marekw1986/8085Computer/code/shadowed_rom/CPMBootloader/README.md

# POLON 7880

This is code of TinyBsic for final version of POLON 7880, build on PCBs.
