marekw1986/8085Computer/hardware/shadower.brd

## EAGLE design hardware/shadower.brd (2025-04-10)

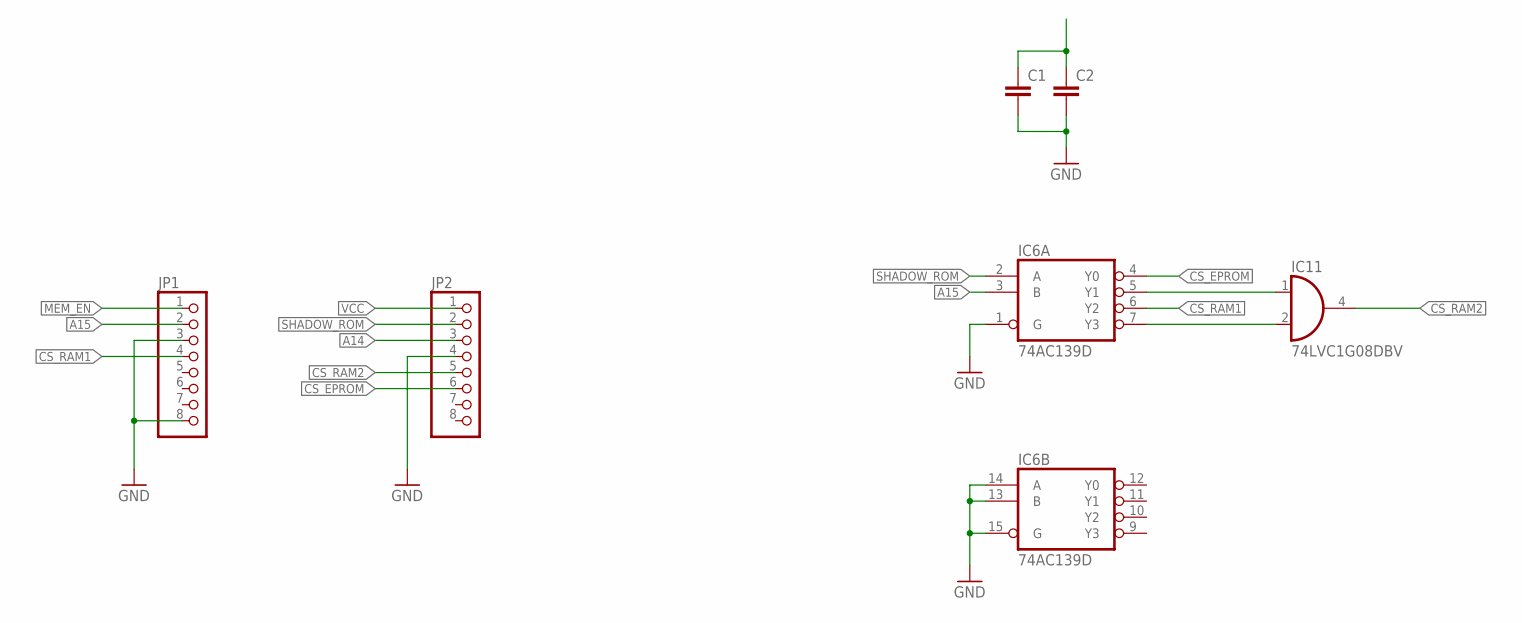
[picture p1: schematic shadower.sch]

Parts:
C1, C2: C-EUC0603; C0603
IC6: 74AC139D; SO16
IC11: 74LVC1G08DBV; SOT23-5
JP1, JP2: PINHD-1X8; 1X08

Connections:
A14: JP2.3
A15: IC6.3 (B), JP1.2
CS_EPROM: IC6.4 (Y0), JP2.6
CS_RAM1: IC6.6 (Y2), JP1.4
CS_RAM2: IC11.4 (O), JP2.5
GND: C1.2, C2.2, IC6.1 (G), IC6.8 (GND), IC6.13 (B), IC6.14 (A), IC6.15 (G), IC11.3 (GND), JP1.3, JP1.8, JP2.4
MEM_EN: JP1.1
unnamed: IC6.5 (Y1), IC11.1 (I0)
unnamed: IC6.7 (Y3), IC11.2 (I1)
SHADOW_ROM: IC6.2 (A), JP2.2
VCC: C1.1, C2.1, IC6.16 (VCC), IC11.5 (VCC), JP2.1

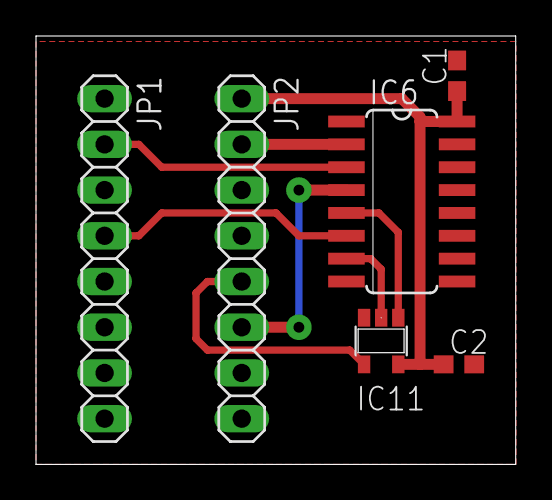
[picture p2: board shadower.brd from above]

Board: 2 copper layers, 26.6 x 23.8 mm, 6 parts (0 on the bottom side), 9 nets.
