marekw1986/8085Computer/hardware/8085_shadow.brd

## EAGLE design hardware/8085_shadow.brd (2025-02-12)

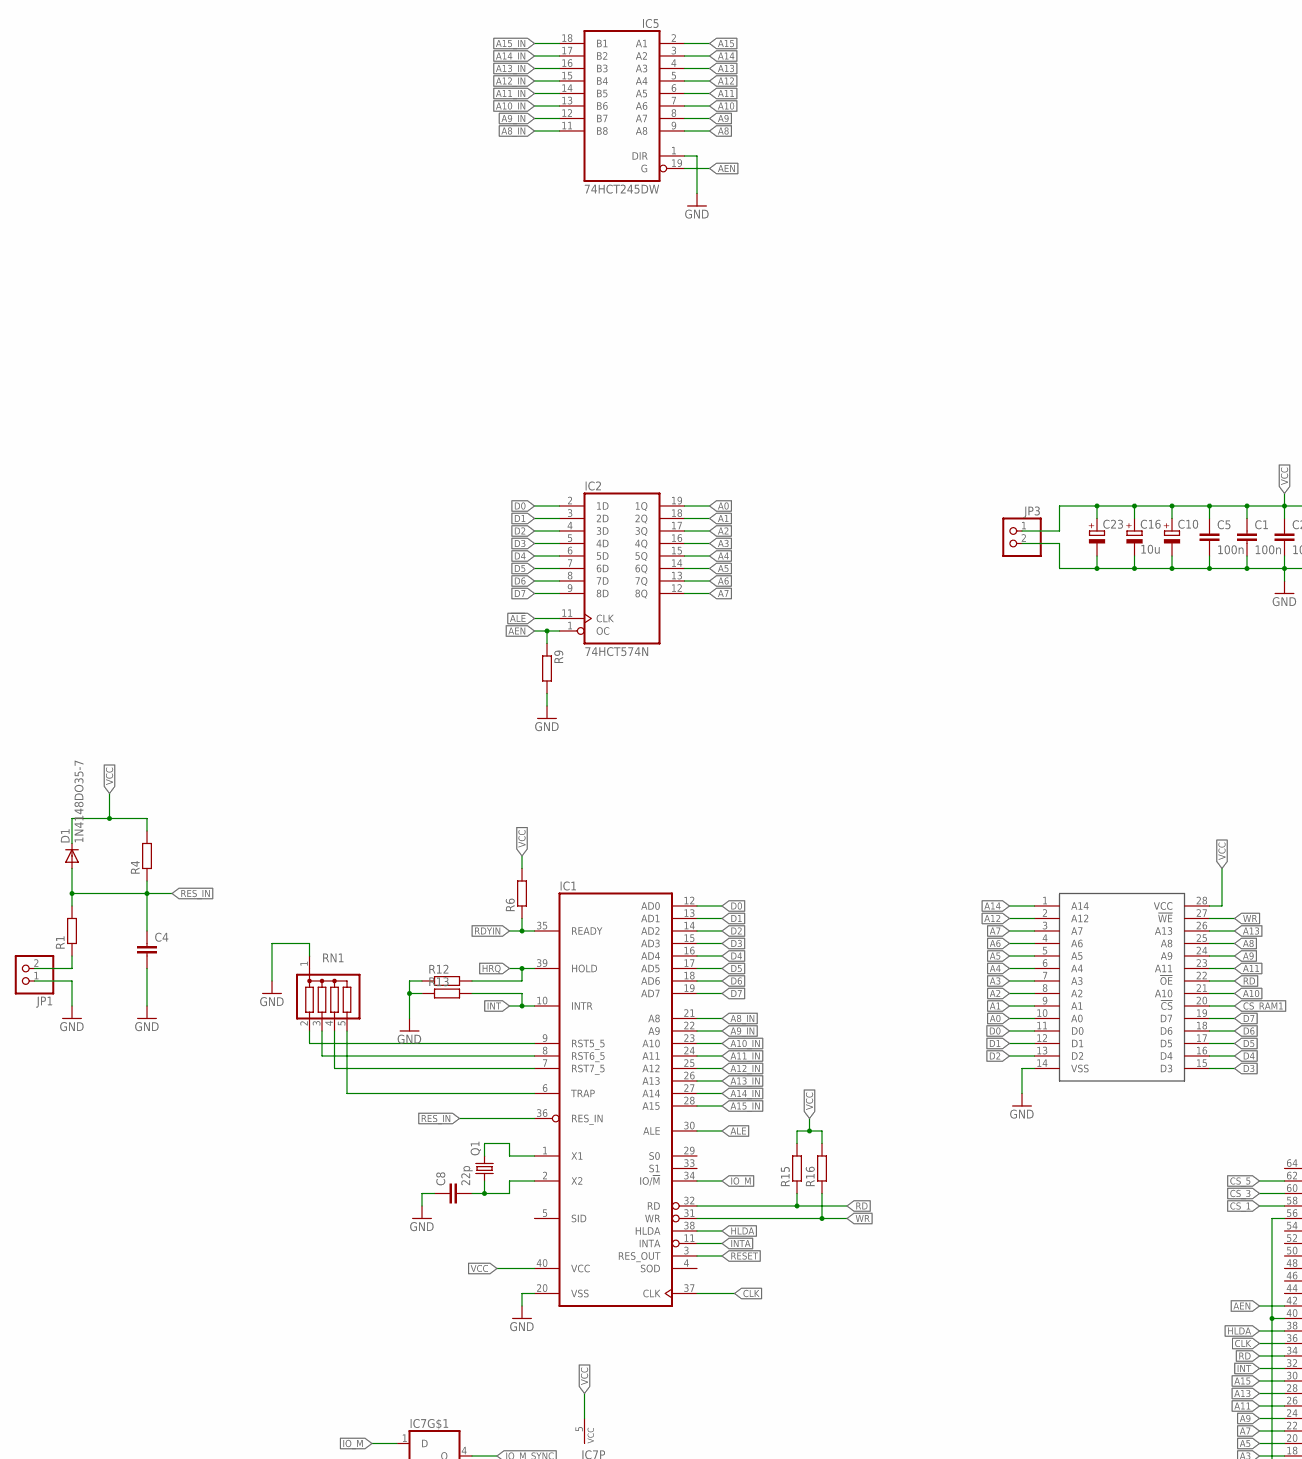
[picture p3: schematic 8085_shadow.sch, part in row 1, column 1]

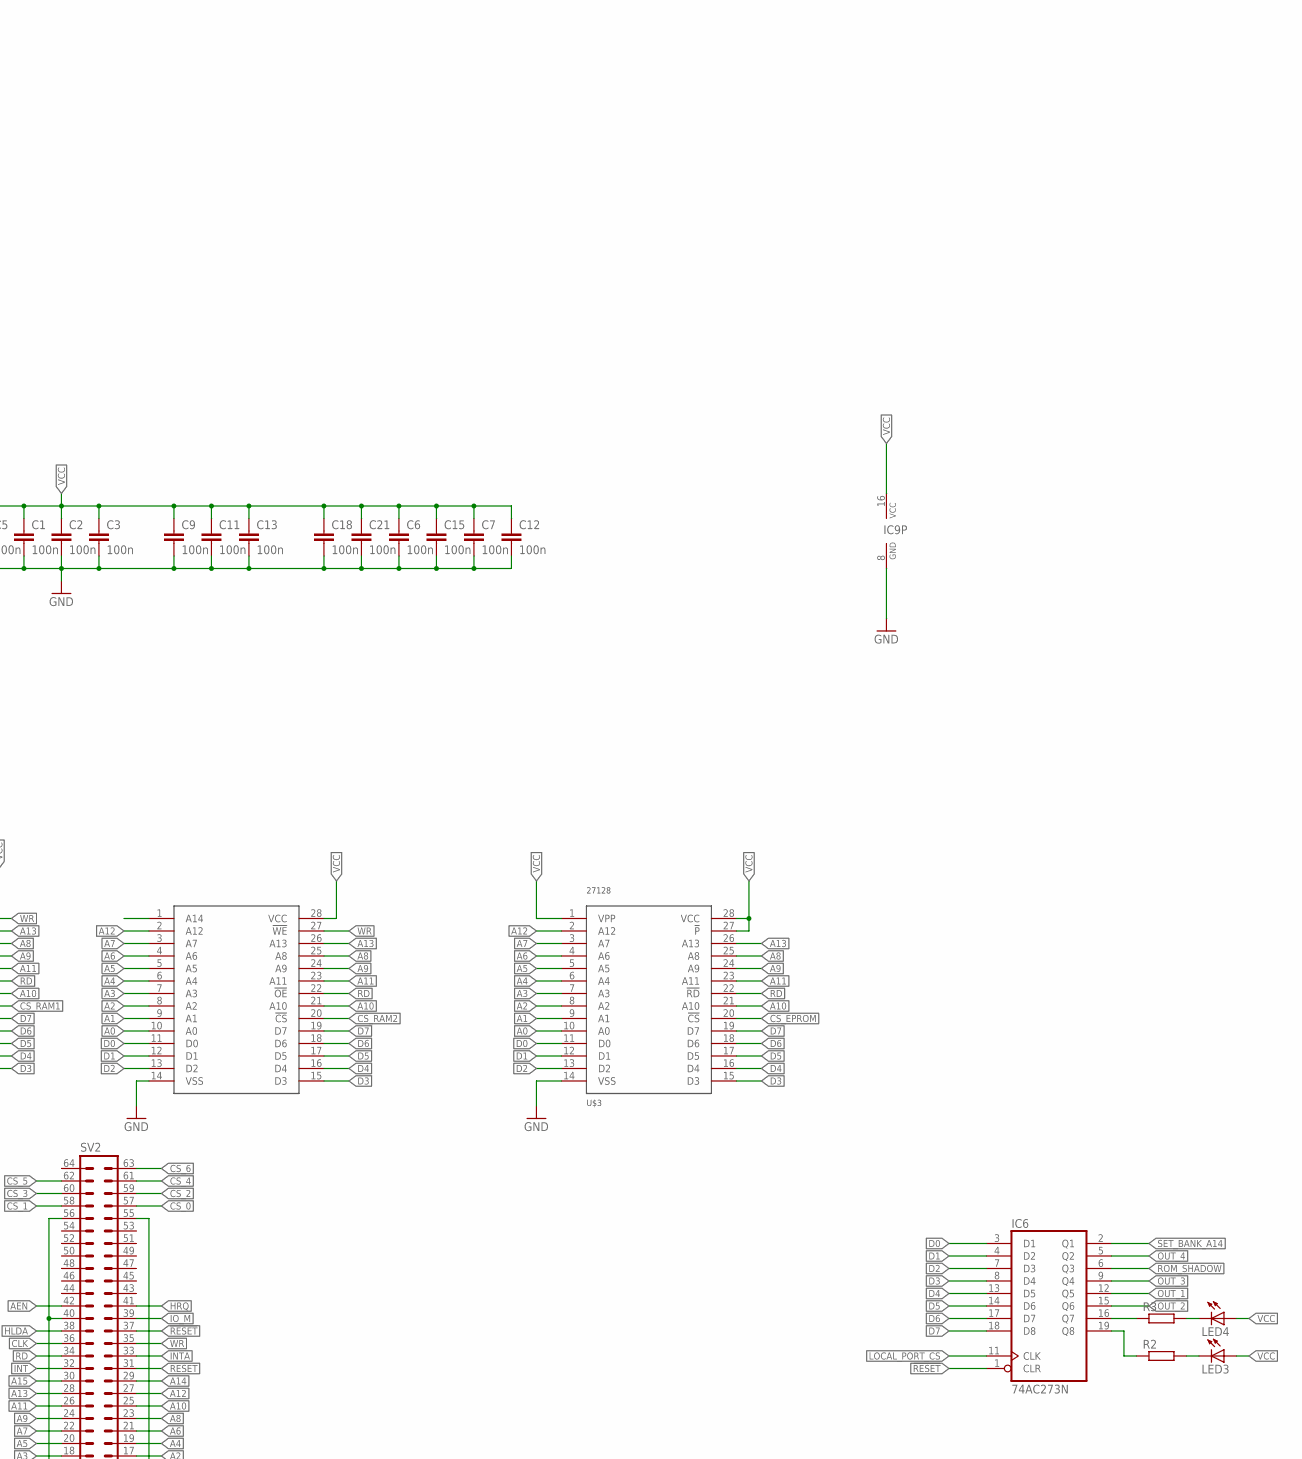
[picture p4: schematic 8085_shadow.sch, part in row 1, column 2]

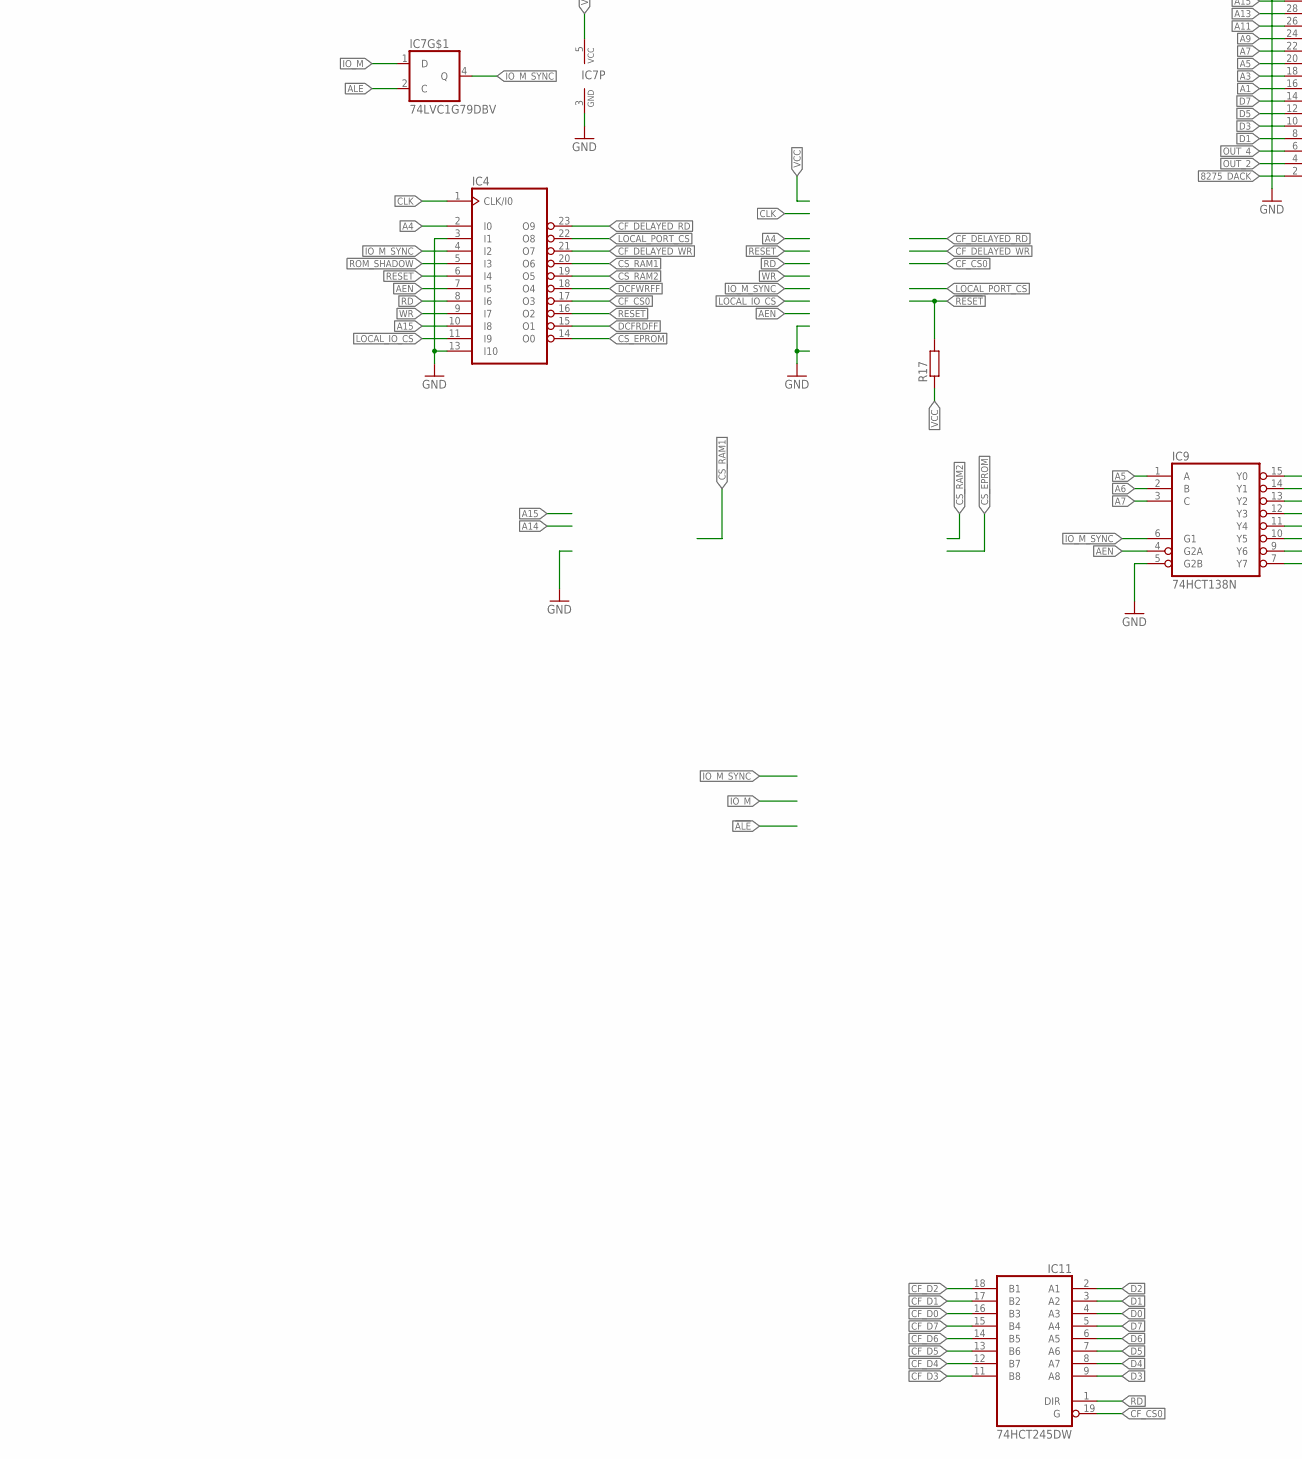
[picture p5: schematic 8085_shadow.sch, part in row 2, column 1]

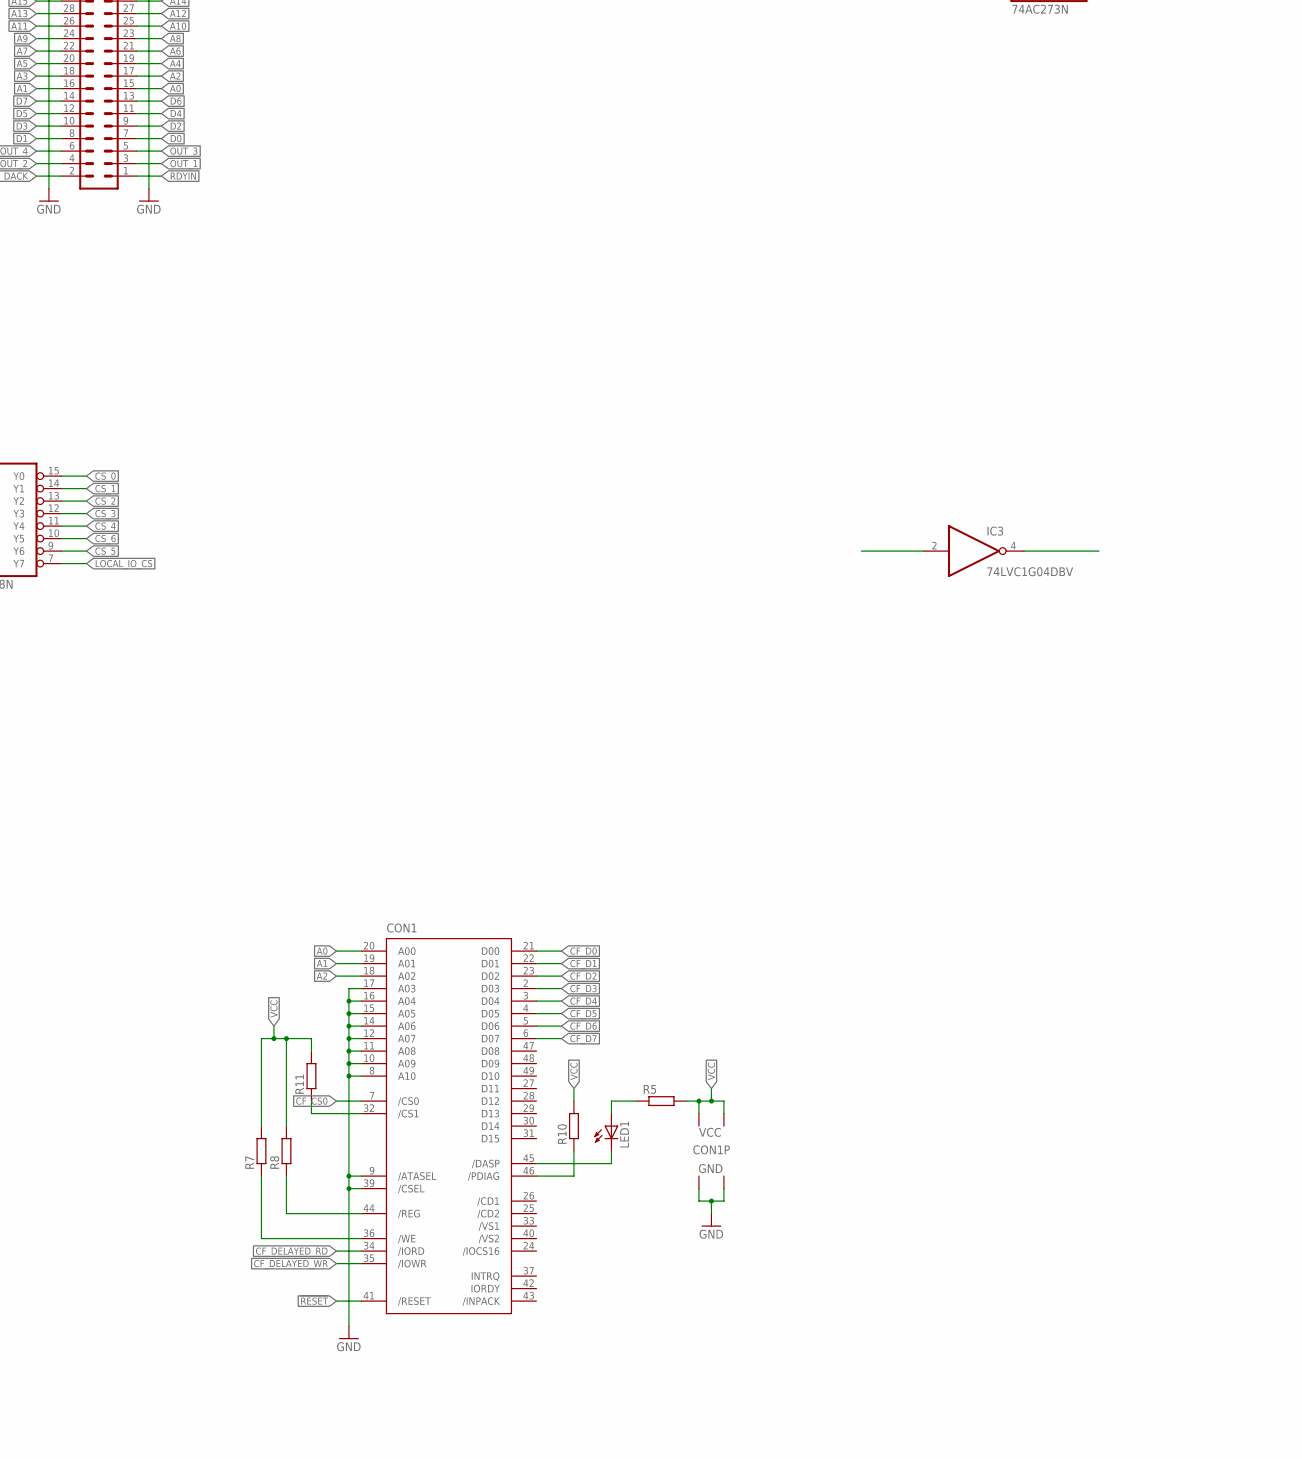
[picture p6: schematic 8085_shadow.sch, part in row 2, column 2]

Parts:
C1, C2, C3, C11, C12, C13: 100n; C0805
C4: C-EUC0603; C0603
C5, C6, C7, C15, C18, C21: 100n; C0603
C8: 22p; C0603
C9: 100n; C1206
C10, C23: CPOL-EUE5-10.5; E5-10,5
C16: 10u; SMC_B
CON1: CF-CARD-IDE_MODE; MI20-50PD-SF
D1: 1N4148DO35-7; DO35-7
IC1: 8085; DIL40
IC2: 74HCT574N; DIL20
IC3: 74LVC1G04DBV; SOT23-5
IC4: 22V10; DIL24-3
IC5, IC11: 74HCT245DW; SO20W
IC6: 74AC273N; DIL20
IC7: 74LVC1G79DBV; SOT23-5
IC9: 74HCT138N; DIL16
JP1, JP3: PINHD-1X2; 1X02
LED1, LED3, LED4: LED5MM
Q1: CRYSTALHC49S; HC49/S
R1, R6: R-EU_0204/5; 0204/5
R2, R3: R-EU_R1206; R1206
R4, R15, R16, R17: R-EU_0204/7; 0204/7
R5, R9, R12, R13: R-EU_R0603; R0603
R7, R11: R-EU_0207/10; 0207/10
R8, R10: R-EU_0207/12; 0207/12
RN1: G04R; SIL5
SV2: ML64L
U$2, U$4: 62256; DIL28-6
U$3: 27128; DIL28

Connections:
8275_DACK: SV2.2
!ALE: IC2.11 (CLK), IC3.4 (O), IC7.2 (C)
!RESET: CON1.41 (/RESET), IC4.16 (O2), IC6.1 (CLR), R17.2, SV2.37
A0: CON1.20 (A00), IC2.19 (1Q), SV2.15, U$2.10 (A0), U$3.10 (A0), U$4.10 (A0)
A1: CON1.19 (A01), IC2.18 (2Q), SV2.16, U$2.9 (A1), U$3.9 (A1), U$4.9 (A1)
A2: CON1.18 (A02), IC2.17 (3Q), SV2.17, U$2.8 (A2), U$3.8 (A2), U$4.8 (A2)
A3: IC2.16 (4Q), SV2.18, U$2.7 (A3), U$3.7 (A3), U$4.7 (A3)
A4: IC2.15 (5Q), IC4.2 (I0), SV2.19, U$2.6 (A4), U$3.6 (A4), U$4.6 (A4)
A5: IC2.14 (6Q), IC9.1 (A), SV2.20, U$2.5 (A5), U$3.5 (A5), U$4.5 (A5)
A6: IC2.13 (7Q), IC9.2 (B), SV2.21, U$2.4 (A6), U$3.4 (A6), U$4.4 (A6)
A7: IC2.12 (8Q), IC9.3 (C), SV2.22, U$2.3 (A7), U$3.3 (A7), U$4.3 (A7)
A8: IC5.9 (A8), SV2.23, U$2.25 (A8), U$3.25 (A8), U$4.25 (A8)
A8_IN: IC1.21 (A8), IC5.11 (B8)
A9: IC5.8 (A7), SV2.24, U$2.24 (A9), U$3.24 (A9), U$4.24 (A9)
A9_IN: IC1.22 (A9), IC5.12 (B7)
A10: IC5.7 (A6), SV2.25, U$2.21 (A10), U$3.21 (A10), U$4.21 (A10)
A10_IN: IC1.23 (A10), IC5.13 (B6)
A11: IC5.6 (A5), SV2.26, U$2.23 (A11), U$3.23 (A11), U$4.23 (A11)
A11_IN: IC1.24 (A11), IC5.14 (B5)
A12: IC5.5 (A4), SV2.27, U$2.2 (A12), U$3.2 (A12), U$4.2 (A12)
A12_IN: IC1.25 (A12), IC5.15 (B4)
A13: IC5.4 (A3), SV2.28, U$2.26 (A13), U$3.26 (A13), U$4.26 (A13)
A13_IN: IC1.26 (A13), IC5.16 (B3)
A14: IC5.3 (A2), SV2.29, U$2.1 (A14), U$4.1 (A14)
A14_IN: IC1.27 (A14), IC5.17 (B2)
A15: IC4.10 (I8), IC5.2 (A1), SV2.30
A15_IN: IC1.28 (A15), IC5.18 (B1)
AEN: IC2.1 (OC), IC4.7 (I5), IC5.19 (G), IC9.4 (G2A), R9.1, SV2.42
ALE: IC1.30 (ALE), IC3.2 (I)
CF_CS0: CON1.7 (/CS0), IC4.17 (O3), IC11.19 (G)
CF_D0: CON1.21 (D00), IC11.16 (B3)
CF_D1: CON1.22 (D01), IC11.17 (B2)
CF_D2: CON1.23 (D02), IC11.18 (B1)
CF_D3: CON1.2 (D03), IC11.11 (B8)
CF_D4: CON1.3 (D04), IC11.12 (B7)
CF_D5: CON1.4 (D05), IC11.13 (B6)
CF_D6: CON1.5 (D06), IC11.14 (B5)
CF_D7: CON1.6 (D07), IC11.15 (B4)
CF_DELAYED_RD: CON1.34 (/IORD), IC4.23 (O9)
CF_DELAYED_WR: CON1.35 (/IOWR), IC4.21 (O7)
CLK: IC1.37 (CLK), IC4.1 (CLK/I0), SV2.36
CS_0: IC9.15 (Y0), SV2.57
CS_1: IC9.14 (Y1), SV2.58
CS_2: IC9.13 (Y2), SV2.59
CS_3: IC9.12 (Y3), SV2.60
CS_4: IC9.11 (Y4), SV2.61
CS_5: IC9.9 (Y6), SV2.62
CS_6: IC9.10 (Y5), SV2.63
CS_EPROM: IC4.14 (O0), U$3.20 (!CS)
CS_RAM1: IC4.20 (O6), U$4.20 (!CS)
CS_RAM2: IC4.19 (O5), U$2.20 (!CS)
D0: IC1.12 (AD0), IC2.2 (1D), IC6.3 (D1), IC11.4 (A3), SV2.7, U$2.11 (D0), U$3.11 (D0), U$4.11 (D0)
D1: IC1.13 (AD1), IC2.3 (2D), IC6.4 (D2), IC11.3 (A2), SV2.8, U$2.12 (D1), U$3.12 (D1), U$4.12 (D1)
D2: IC1.14 (AD2), IC2.4 (3D), IC6.7 (D3), IC11.2 (A1), SV2.9, U$2.13 (D2), U$3.13 (D2), U$4.13 (D2)
D3: IC1.15 (AD3), IC2.5 (4D), IC6.8 (D4), IC11.9 (A8), SV2.10, U$2.15 (D3), U$3.15 (D3), U$4.15 (D3)
D4: IC1.16 (AD4), IC2.6 (5D), IC6.13 (D5), IC11.8 (A7), SV2.11, U$2.16 (D4), U$3.16 (D4), U$4.16 (D4)
D5: IC1.17 (AD5), IC2.7 (6D), IC6.14 (D6), IC11.7 (A6), SV2.12, U$2.17 (D5), U$3.17 (D5), U$4.17 (D5)
D6: IC1.18 (AD6), IC2.8 (7D), IC6.17 (D7), IC11.6 (A5), SV2.13, U$2.18 (D6), U$3.18 (D6), U$4.18 (D6)
D7: IC1.19 (AD7), IC2.9 (8D), IC6.18 (D8), IC11.5 (A4), SV2.14, U$2.19 (D7), U$3.19 (D7), U$4.19 (D7)
DCFRDFF: IC4.15 (O1)
DCFWRFF: IC4.18 (O4)
GND: C1.2, C2.2, C3.2, C4.2, C5.2, C6.2, C7.2, C8.1, C9.2, C10.-, C11.2, C12.2, C13.2, C15.2, C16.-, C18.2, C21.2, C23.-, CON1.1 (GND1), CON1.8 (A10), CON1.9 (/ATASEL), CON1.10 (A09), CON1.11 (A08), CON1.12 (A07), CON1.14 (A06), CON1.15 (A05), CON1.16 (A04), CON1.17 (A03), CON1.39 (/CSEL), CON1.50 (GND2), IC1.20 (VSS), IC2.10 (GND), IC3.3 (GND), IC4.3 (I1), IC4.12 (GND), IC4.13 (I10), IC5.1 (DIR), IC5.10 (GND), IC6.10 (GND), IC7.3 (GND), IC9.5 (G2B), IC9.8 (GND), IC11.10 (GND), JP1.1, JP3.2, R9.2, R12.1, R13.1, RN1.1, SV2.40, SV2.55, SV2.56, U$2.14 (VSS), U$3.14 (VSS), U$4.14 (VSS)
HLDA: IC1.38 (HLDA), SV2.38
HRQ: IC1.39 (HOLD), R12.2, SV2.41
INT: IC1.10 (INTR), R13.2, SV2.32
INTA: IC1.11 (INTA), SV2.33
IO_M: IC1.34 (IO/!M), IC7.1 (D), SV2.39
IO_M_SYNC: IC4.4 (I2), IC7.4 (Q), IC9.6 (G1)
LOCAL_IO_CS: IC4.11 (I9), IC9.7 (Y7)
LOCAL_PORT_CS: IC4.22 (O8), IC6.11 (CLK)
unnamed: IC1.1 (X1), Q1.2
unnamed: C8.2, IC1.2 (X2), Q1.1
unnamed: IC1.9 (RST5_5), RN1.2
unnamed: IC1.8 (RST6_5), RN1.3
unnamed: IC6.16 (Q7), R3.1
unnamed: IC1.7 (RST7_5), RN1.4
unnamed: IC1.6 (TRAP), RN1.5
unnamed: LED3.K (C), R2.2
unnamed: LED4.K (C), R3.2
unnamed: IC6.19 (Q8), R2.1
unnamed: CON1.44 (/REG), R8.1
unnamed: CON1.36 (/WE), R7.1
unnamed: CON1.46 (/PDIAG), R10.1
unnamed: JP1.2, R1.1
unnamed: LED1.A, R5.1
unnamed: CON1.45 (/DASP), LED1.K (C)
unnamed: CON1.32 (/CS1), R11.1
OUT_1: IC6.12 (Q5), SV2.3
OUT_2: IC6.15 (Q6), SV2.4
OUT_3: IC6.9 (Q4), SV2.5
OUT_4: IC6.5 (Q2), SV2.6
RD: IC1.32 (RD), IC4.8 (I6), IC11.1 (DIR), R15.1, SV2.34, U$2.22 (!OE), U$3.22 (!RD), U$4.22 (!OE)
RDYIN: IC1.35 (READY), R6.1, SV2.1
RESET: IC1.3 (RES_OUT), IC4.6 (I4), SV2.31
RES_IN: C4.1, D1.A, IC1.36 (RES_IN), R1.2, R4.1
ROM_SHADOW: IC4.5 (I3), IC6.6 (Q3)
SET_BANK_A14: IC6.2 (Q1)
VCC: C1.1, C2.1, C3.1, C5.1, C6.1, C7.1, C9.1, C10.+, C11.1, C12.1, C13.1, C15.1, C16.+, C18.1, C21.1, C23.+, CON1.13 (VCC2), CON1.38 (VCC1), D1.C, IC1.40 (VCC), IC2.20 (VCC), IC3.5 (VCC), IC4.24 (VCC), IC5.20 (VCC), IC6.20 (VCC), IC7.5 (VCC), IC9.16 (VCC), IC11.20 (VCC), JP3.1, LED3.A, LED4.A, R4.2, R5.2, R6.2, R7.2, R8.2, R10.2, R11.2, R15.2, R16.2, R17.1, U$2.28 (VCC), U$3.1 (VPP), U$3.27 (!P), U$3.28 (VCC), U$4.28 (VCC)
WR: IC1.31 (WR), IC4.9 (I7), R16.1, SV2.35, U$2.27 (!WE), U$4.27 (!WE)

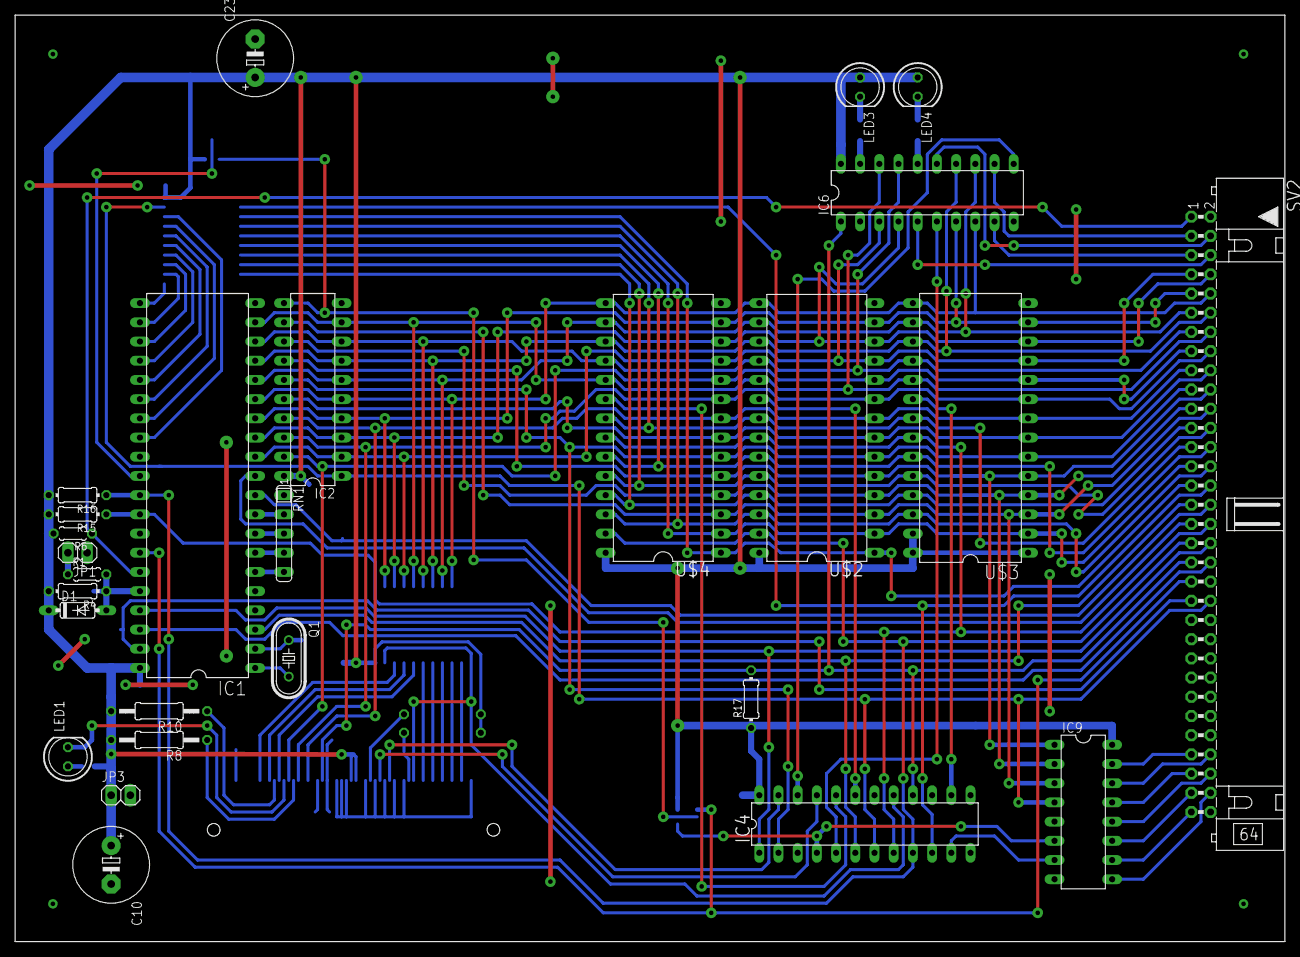
[picture p7: board 8085_shadow.brd from above]

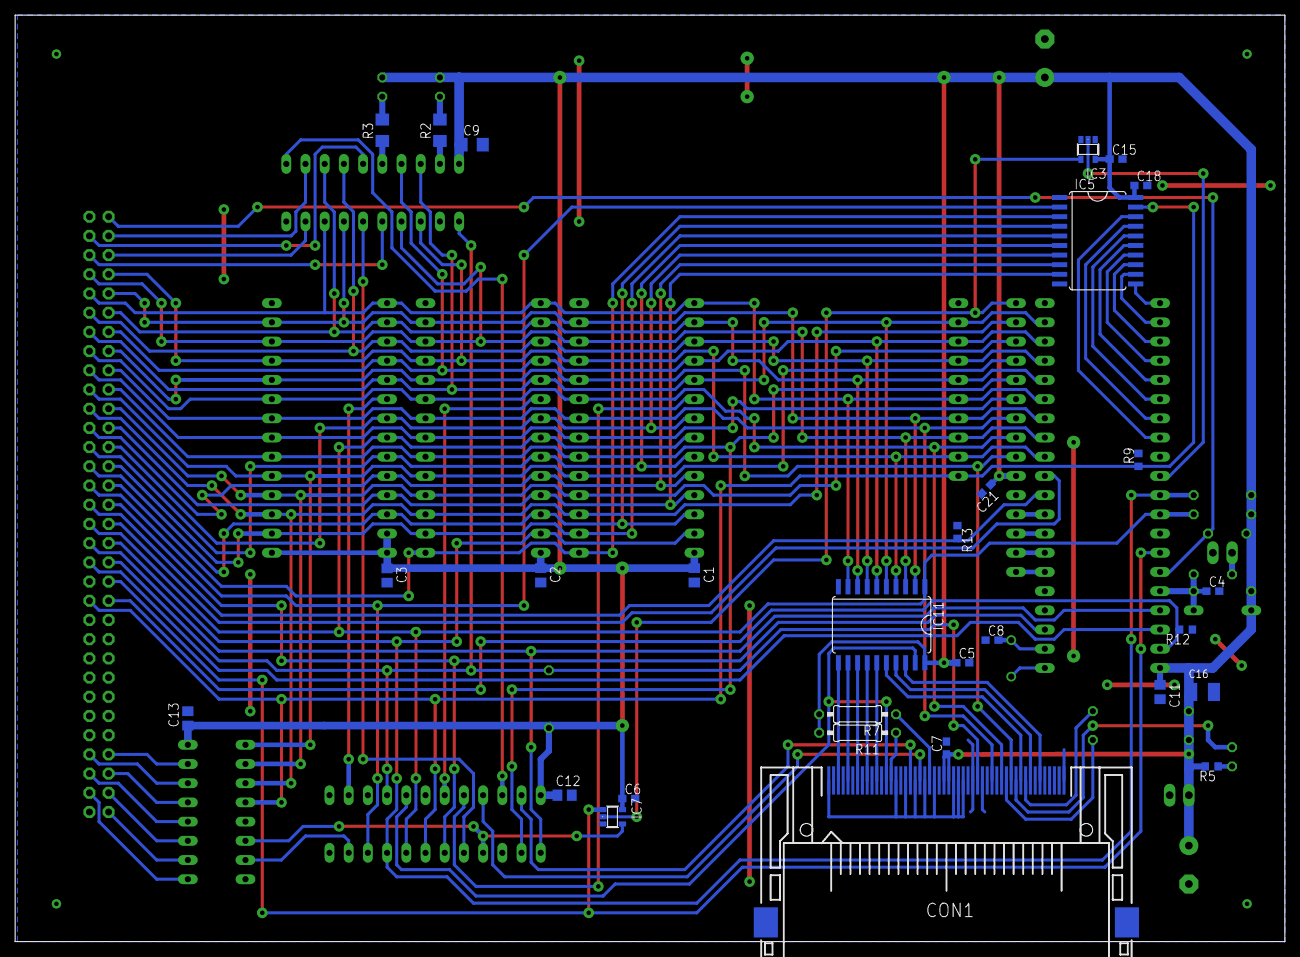
[picture p8: board 8085_shadow.brd from below]

Board: 2 copper layers, 167.9 x 122.5 mm, 56 parts (29 on the bottom side), 95 nets.
