marekw1986/8085Computer/hardware/8085_IO_LCD.brd

## EAGLE design hardware/8085_IO_LCD.brd (2024-09-18)

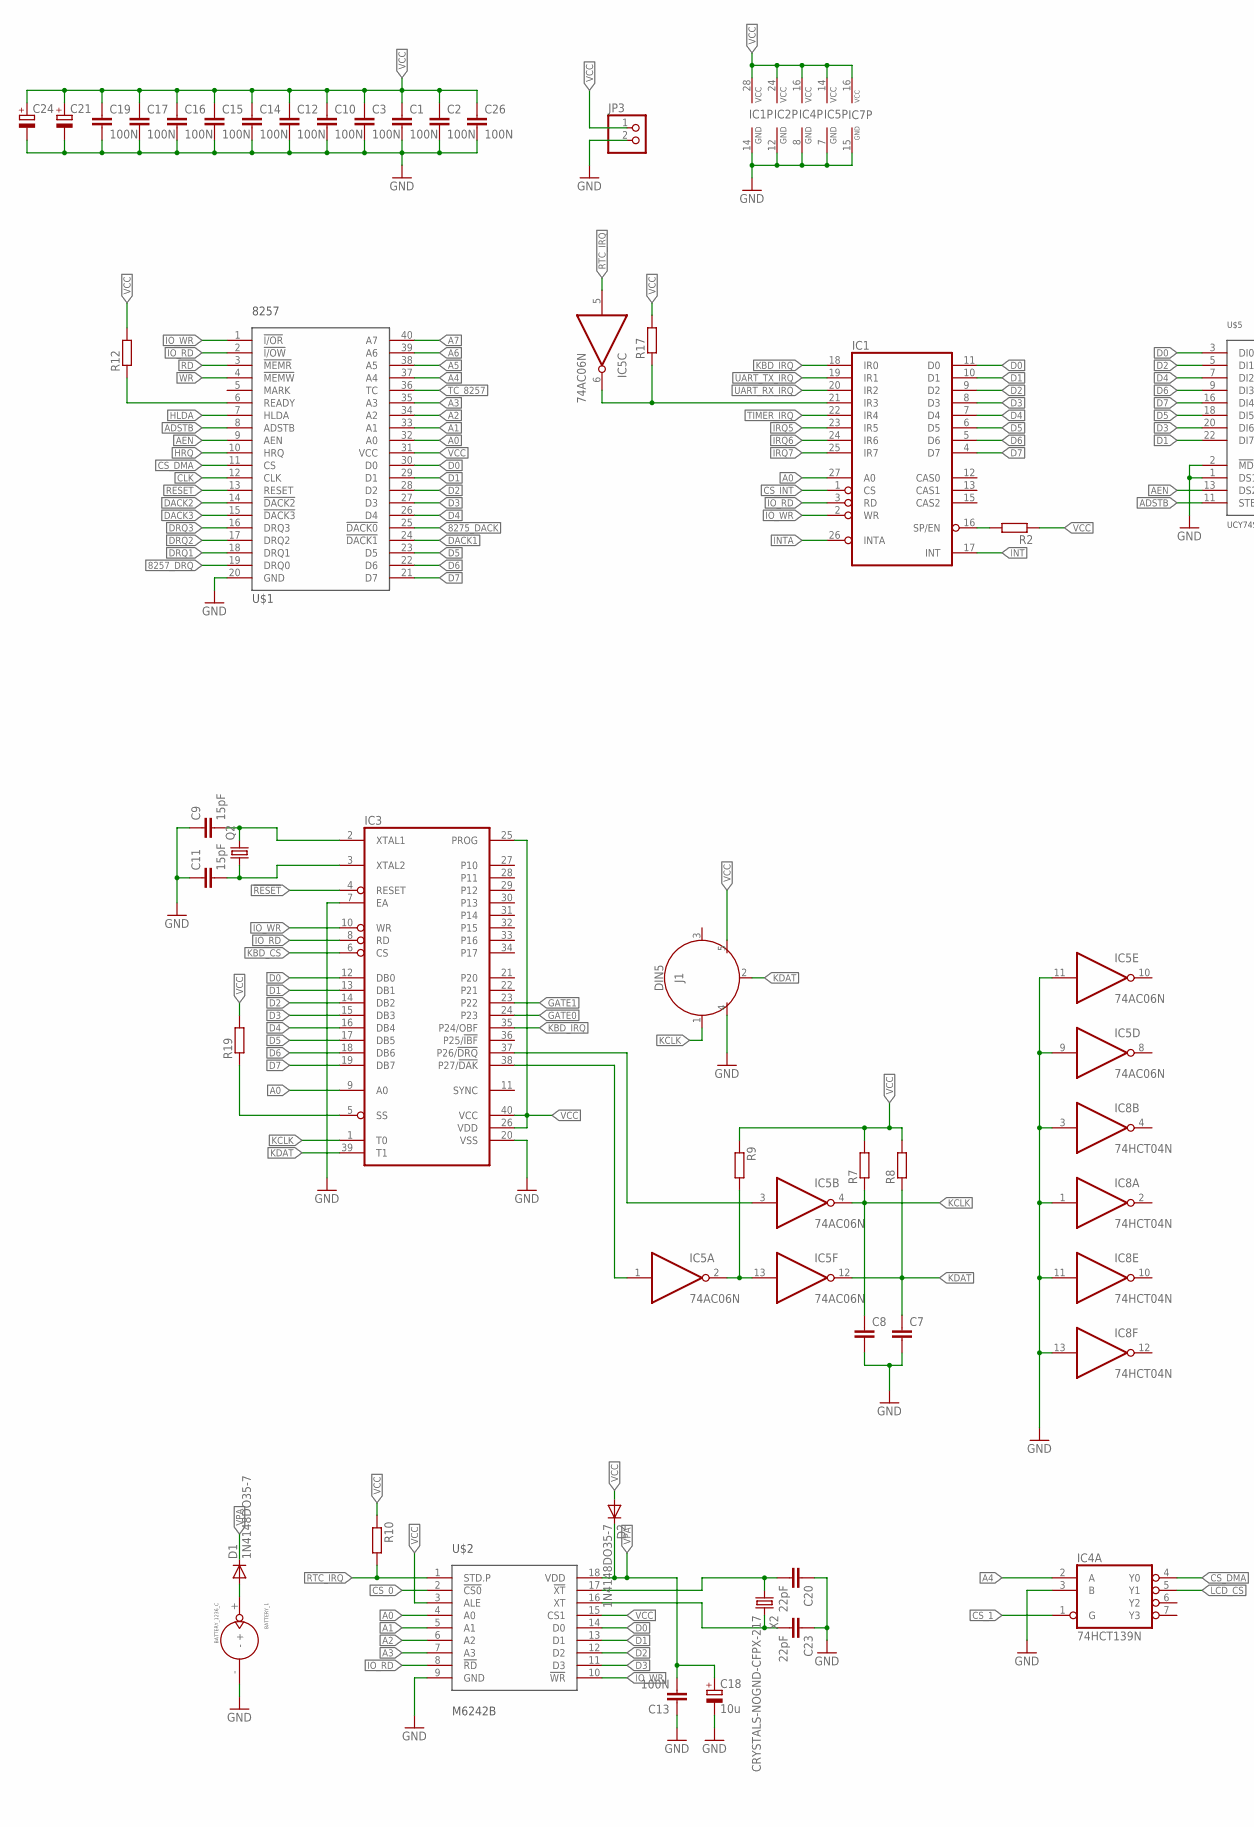
[picture p9: schematic 8085_IO_LCD.sch, part in row 1, column 1]

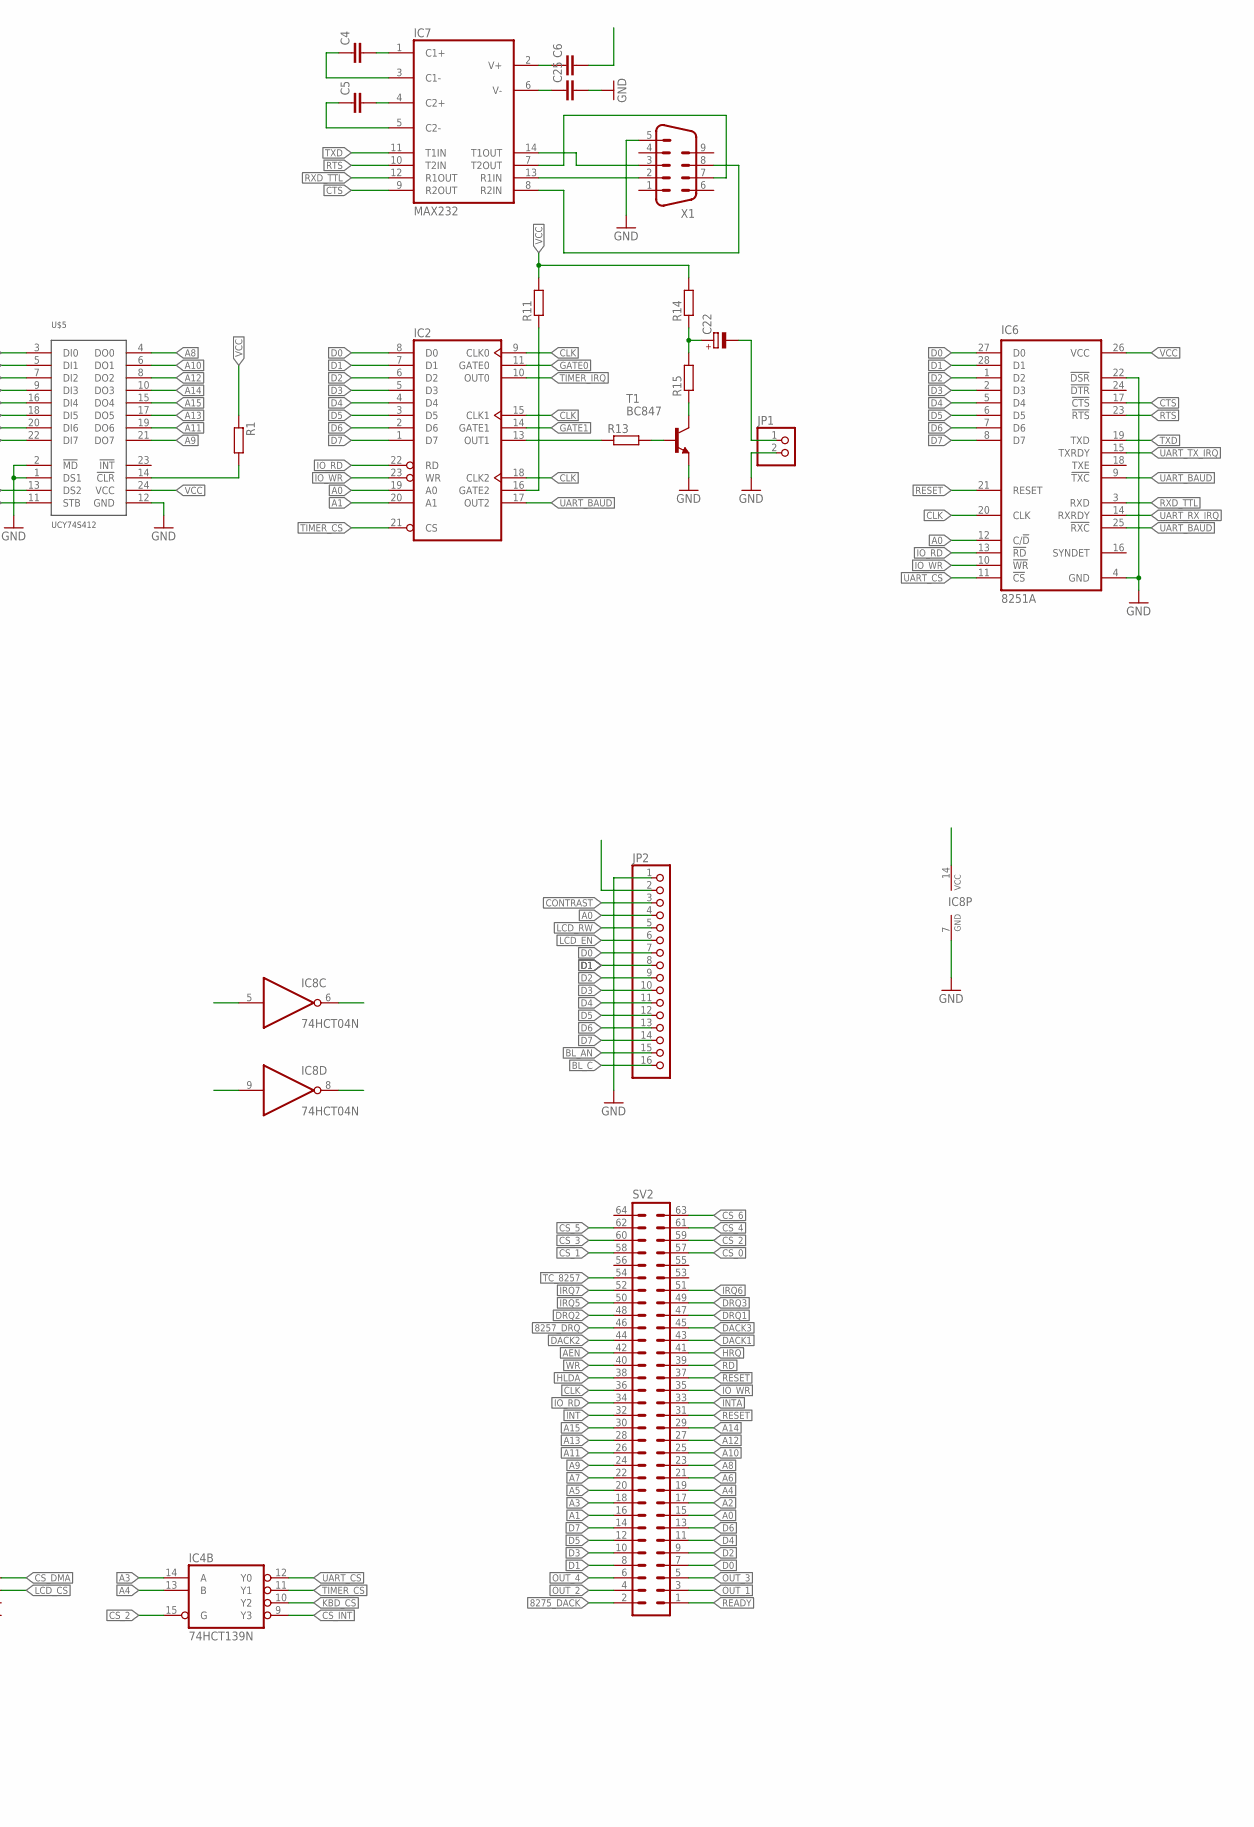
[picture p10: schematic 8085_IO_LCD.sch, part in row 1, column 2]

Parts:
BATTERY_1: BATTERY_1236_C
C1, C3, C10, C12, C13, C14, C15, C16, C17, C19: 100N; C0603
C2: 100N; C1206
C4, C5, C6, C7, C8, C25: C-EUC0603; C0603
C9, C11: 15pF; C0603
C18: 10u; SMC_B
C20, C23: 22pF; C0603
C21: CPOL-EUE3.5-8; E3,5-8
C22: CPOL-EUE2-4; E2-4
C24: CPOL-EUSMCB; SMC_B
C26: 100N; C0805
D1, D2: 1N4148DO35-7; DO35-7
IC1: 8259A; DIL28-6
IC2: 8253; DIL24-6
IC3: UPI-8042AH; DIL40
IC4: 74HCT139N; DIL16
IC5: 74AC06N; DIL14
IC6: 8251A; DIL28-6
IC7: MAX232; DIL16
IC8: 74HCT04N; DIL14
J1: DIN5; DIN5-RA-PTH
JP1: PINHD-1X2; 1X02
JP2: PINHD-1X16; 1X16
JP3: PINHD-1X2/90; 1X02/90
Q2: CRYSTALHC49S; HC49/S
R1, R2, R9, R10, R11, R12, R13, R15: R-EU_R0603; R0603
R7, R14, R19: R-EU_0204/5; 0204/5
R8: R-EU_M0805; M0805
R17: R-EU_0204/7; 0204/7
SV2: ML64L
T1: BC847; SOT23
U$1: 8257; DIL40
U$2: M6242B; DIL18
U$5: UCY74S412; DIL24-6
X1: M09HP
X2: CRYSTALS-NOGND-CFPX-217; 3.2X1.5-2-PAD

Connections:
8257_DRQ: SV2.46, U$1.19 (DRQ0)
8275_DACK: SV2.2, U$1.25 (!DACK0)
!RESET: IC3.4 (RESET), SV2.37
A0: IC1.27 (A0), IC2.19 (A0), IC3.9 (A0), IC6.12 (C/!D), JP2.4, SV2.15, U$1.32 (A0), U$2.4 (A0)
A1: IC2.20 (A1), SV2.16, U$1.33 (A1), U$2.5 (A1)
A2: SV2.17, U$1.34 (A2), U$2.6 (A2)
A3: IC4.14 (A), SV2.18, U$1.35 (A3), U$2.7 (A3)
A4: IC4.2 (A), IC4.13 (B), SV2.19, U$1.37 (A4)
A5: SV2.20, U$1.38 (A5)
A6: SV2.21, U$1.39 (A6)
A7: SV2.22, U$1.40 (A7)
A8: SV2.23, U$5.4 (DO0)
A9: SV2.24, U$5.21 (DO7)
A10: SV2.25, U$5.6 (DO1)
A11: SV2.26, U$5.19 (DO6)
A12: SV2.27, U$5.8 (DO2)
A13: SV2.28, U$5.17 (DO5)
A14: SV2.29, U$5.10 (DO3)
A15: SV2.30, U$5.15 (DO4)
ADSTB: U$1.8 (ADSTB), U$5.11 (STB)
AEN: SV2.42, U$1.9 (AEN), U$5.13 (DS2)
BL_AN: JP2.15
BL_C: JP2.16
CLK: IC2.9 (CLK0), IC2.15 (CLK1), IC2.18 (CLK2), IC6.20 (CLK), SV2.36, U$1.12 (CLK)
CONTRAST: JP2.3
CS_0: SV2.57, U$2.2 (!CS0)
CS_1: IC4.1 (G), SV2.58
CS_2: IC4.15 (G), SV2.59
CS_3: SV2.60
CS_4: SV2.61
CS_5: SV2.62
CS_6: SV2.63
CS_DMA: IC4.4 (Y0), U$1.11 (CS)
CS_INT: IC1.1 (CS), IC4.9 (Y3)
CTS: IC6.17 (!CTS), IC7.9 (R2OUT)
D0: IC1.11 (D0), IC2.8 (D0), IC3.12 (DB0), IC6.27 (D0), JP2.7, SV2.7, U$1.30 (D0), U$2.14 (D0), U$5.3 (DI0)
D1: IC1.10 (D1), IC2.7 (D1), IC3.13 (DB1), IC6.28 (D1), JP2.8, SV2.8, U$1.29 (D1), U$2.13 (D1), U$5.22 (DI7)
D2: IC1.9 (D2), IC2.6 (D2), IC3.14 (DB2), IC6.1 (D2), JP2.9, SV2.9, U$1.28 (D2), U$2.12 (D2), U$5.5 (DI1)
D3: IC1.8 (D3), IC2.5 (D3), IC3.15 (DB3), IC6.2 (D3), JP2.10, SV2.10, U$1.27 (D3), U$2.11 (D3), U$5.20 (DI6)
D4: IC1.7 (D4), IC2.4 (D4), IC3.16 (DB4), IC6.5 (D4), JP2.11, SV2.11, U$1.26 (D4), U$5.7 (DI2)
D5: IC1.6 (D5), IC2.3 (D5), IC3.17 (DB5), IC6.6 (D5), JP2.12, SV2.12, U$1.23 (D5), U$5.18 (DI5)
D6: IC1.5 (D6), IC2.2 (D6), IC3.18 (DB6), IC6.7 (D6), JP2.13, SV2.13, U$1.22 (D6), U$5.9 (DI3)
D7: IC1.4 (D7), IC2.1 (D7), IC3.19 (DB7), IC6.8 (D7), JP2.14, SV2.14, U$1.21 (D7), U$5.16 (DI4)
DACK1: SV2.43, U$1.24 (!DACK1)
DACK2: SV2.44, U$1.14 (!DACK2)
DACK3: SV2.45, U$1.15 (!DACK3)
DRQ1: SV2.47, U$1.18 (DRQ1)
DRQ2: SV2.48, U$1.17 (DRQ2)
DRQ3: SV2.49, U$1.16 (DRQ3)
GATE0: IC2.11 (GATE0), IC3.24 (P23)
GATE1: IC2.14 (GATE1), IC3.23 (P22)
GATE2: IC2.16 (GATE2), R11.1
GND: BATTERY_1.-, C1.2, C2.2, C3.2, C7.2, C8.2, C9.1, C10.2, C11.1, C12.2, C13.1, C14.2, C15.2, C16.2, C17.2, C18.-, C19.2, C20.1, C21.-, C23.1, C24.-, C25.2, C26.2, IC1.14 (GND), IC2.12 (GND), IC3.7 (EA), IC3.20 (VSS), IC4.3 (B), IC4.8 (GND), IC5.7 (GND), IC5.9 (I), IC5.11 (I), IC6.4 (GND), IC6.22 (!DSR), IC7.15 (GND), IC8.1 (I), IC8.3 (I), IC8.7 (GND), IC8.11 (I), IC8.13 (I), J1.4, JP1.2, JP2.1, JP3.2, T1.2 (E), U$1.20 (GND), U$2.9 (GND), U$5.1 (DS1), U$5.2 (!MD), U$5.12 (GND), X1.5
HLDA: SV2.38, U$1.7 (HLDA)
HRQ: SV2.41, U$1.10 (HRQ)
INT: IC1.17 (INT), SV2.32
INTA: IC1.26 (INTA), SV2.33
IO_RD: IC1.3 (RD), IC2.22 (RD), IC3.8 (RD), IC6.13 (!RD), IC8.5 (I), SV2.34, U$1.2 (!I/OW), U$2.8 (!RD)
IO_WR: IC1.2 (WR), IC2.23 (WR), IC3.10 (WR), IC6.10 (!WR), SV2.35, U$1.1 (!I/OR), U$2.10 (!WR)
IRQ5: IC1.23 (IR5), SV2.50
IRQ6: IC1.24 (IR6), SV2.51
IRQ7: IC1.25 (IR7), SV2.52
KBD_CS: IC3.6 (CS), IC4.10 (Y2)
KBD_IRQ: IC1.18 (IR0), IC3.35 (P24/OBF)
KCLK: C8.1, IC3.1 (T0), IC5.4 (O), J1.1, R7.1
KDAT: C7.1, IC3.39 (T1), IC5.12 (O), J1.2, R8.1
LCD_CS: IC4.5 (Y1), IC8.9 (I)
LCD_EN: IC8.8 (O), JP2.6
LCD_RW: IC8.6 (O), JP2.5
unnamed: R1.2, U$5.14 (!CLR)
unnamed: IC1.16 (SP/EN), R2.2
unnamed: IC3.38 (P27/!DAK), IC5.1 (I)
unnamed: R12.1, U$1.6 (READY)
unnamed: IC2.13 (OUT1), R13.1
unnamed: IC7.7 (T2OUT), X1.7
unnamed: IC7.13 (R1IN), X1.2
unnamed: C4.2, IC7.1 (C1+)
unnamed: C5.2, IC7.4 (C2+)
unnamed: C5.1, IC7.5 (C2-)
unnamed: C4.1, IC7.3 (C1-)
unnamed: C6.1, IC7.2 (V+)
unnamed: C25.1, IC7.6 (V-)
unnamed: C9.2, IC3.2 (XTAL1), Q2.2
unnamed: C11.2, IC3.3 (XTAL2), Q2.1
unnamed: IC3.37 (P26/!DRQ), IC5.3 (I)
unnamed: IC7.14 (T1OUT), X1.3
unnamed: IC5.2 (O), IC5.13 (I), R9.2
unnamed: BATTERY_1.+, D1.A
unnamed: R13.2, T1.1 (B)
unnamed: R15.1, T1.3 (C)
unnamed: IC7.8 (R2IN), X1.8
unnamed: C22.-, JP1.1
unnamed: C22.+, R14.1, R15.2
unnamed: IC1.21 (IR3), IC5.6 (O), R17.1
unnamed: IC3.5 (SS), R19.1
OUT_1: SV2.3
OUT_2: SV2.4
OUT_3: SV2.5
OUT_4: SV2.6
RD: SV2.39, U$1.3 (!MEMR)
READY: SV2.1
RESET: IC6.21 (RESET), SV2.31, U$1.13 (RESET)
RTC_IRQ: IC5.5 (I), R10.2, U$2.1 (STD.P)
RTS: IC6.23 (!RTS), IC7.10 (T2IN)
RXD_TTL: IC6.3 (RXD), IC7.12 (R1OUT)
SOSCI: C20.2, U$2.17 (!XT), X2.1
SOSCO: C23.2, U$2.16 (XT), X2.2
TC_8257: SV2.54, U$1.36 (TC)
TIMER_CS: IC2.21 (CS), IC4.11 (Y1)
TIMER_IRQ: IC1.22 (IR4), IC2.10 (OUT0)
TXD: IC6.19 (TXD), IC7.11 (T1IN)
UART_BAUD: IC2.17 (OUT2), IC6.9 (!TXC), IC6.25 (!RXC)
UART_CS: IC4.12 (Y0), IC6.11 (!CS)
UART_RX_IRQ: IC1.20 (IR2), IC6.14 (RXRDY)
UART_TX_IRQ: IC1.19 (IR1), IC6.15 (TXRDY)
VCC: C1.1, C2.1, C3.1, C6.2, C10.1, C12.1, C14.1, C15.1, C16.1, C17.1, C19.1, C21.+, C24.+, C26.1, D2.A, IC1.28 (VCC), IC2.24 (VCC), IC3.25 (PROG), IC3.26 (VDD), IC3.40 (VCC), IC4.16 (VCC), IC5.14 (VCC), IC6.26 (VCC), IC7.16 (VCC), IC8.14 (VCC), J1.5, JP2.2, JP3.1, R1.1, R2.1, R7.2, R8.2, R9.1, R10.1, R11.2, R12.2, R14.2, R17.2, R19.2, U$1.31 (VCC), U$2.3 (ALE), U$2.15 (CS1), U$5.24 (VCC)
VPA: C13.2, C18.+, D1.C, D2.C, U$2.18 (VDD)
WR: SV2.40, U$1.4 (!MEMW)

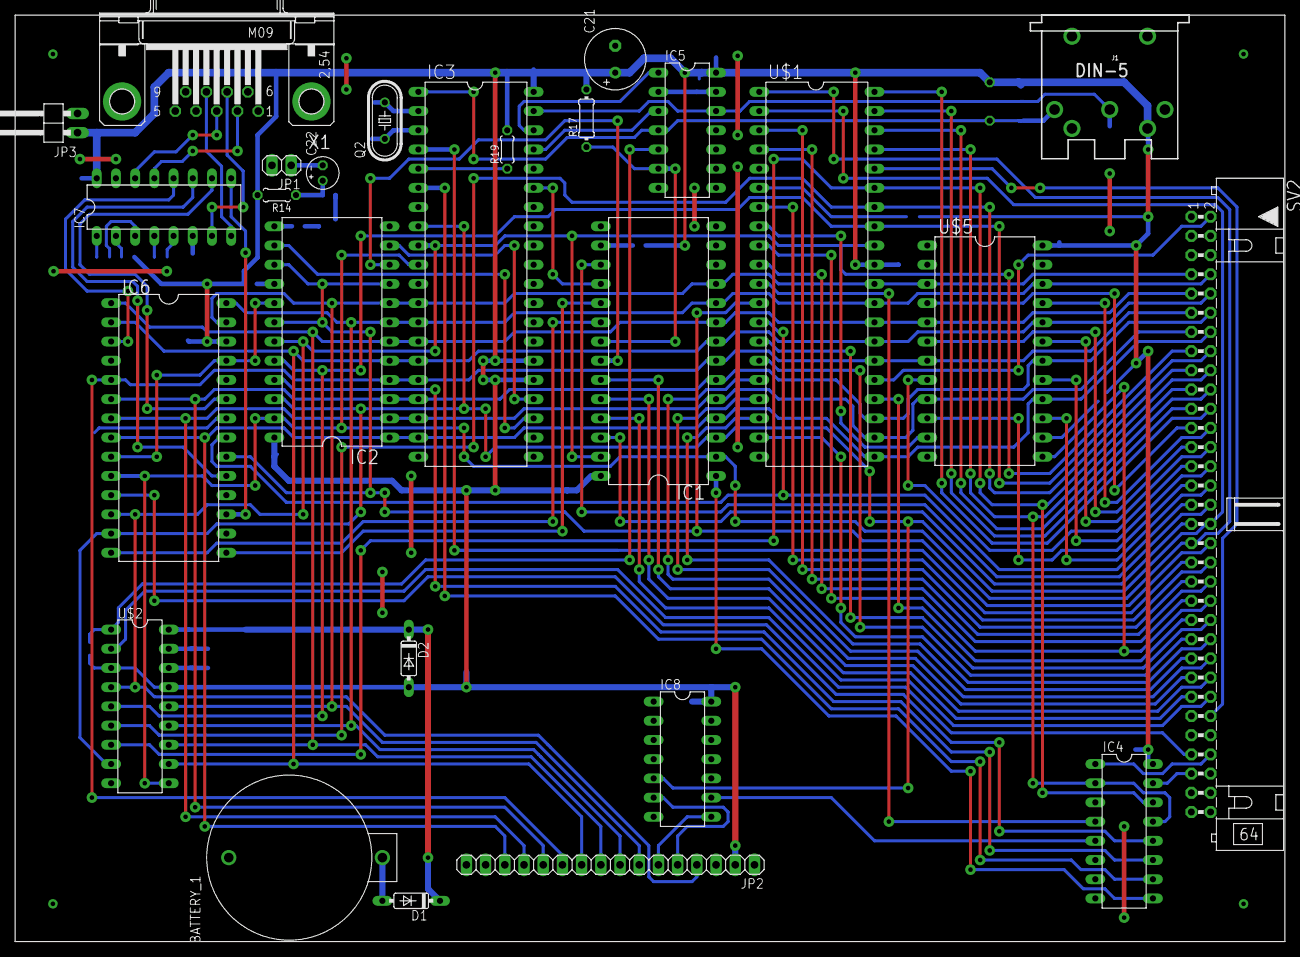
[picture p11: board 8085_IO_LCD.brd from above]

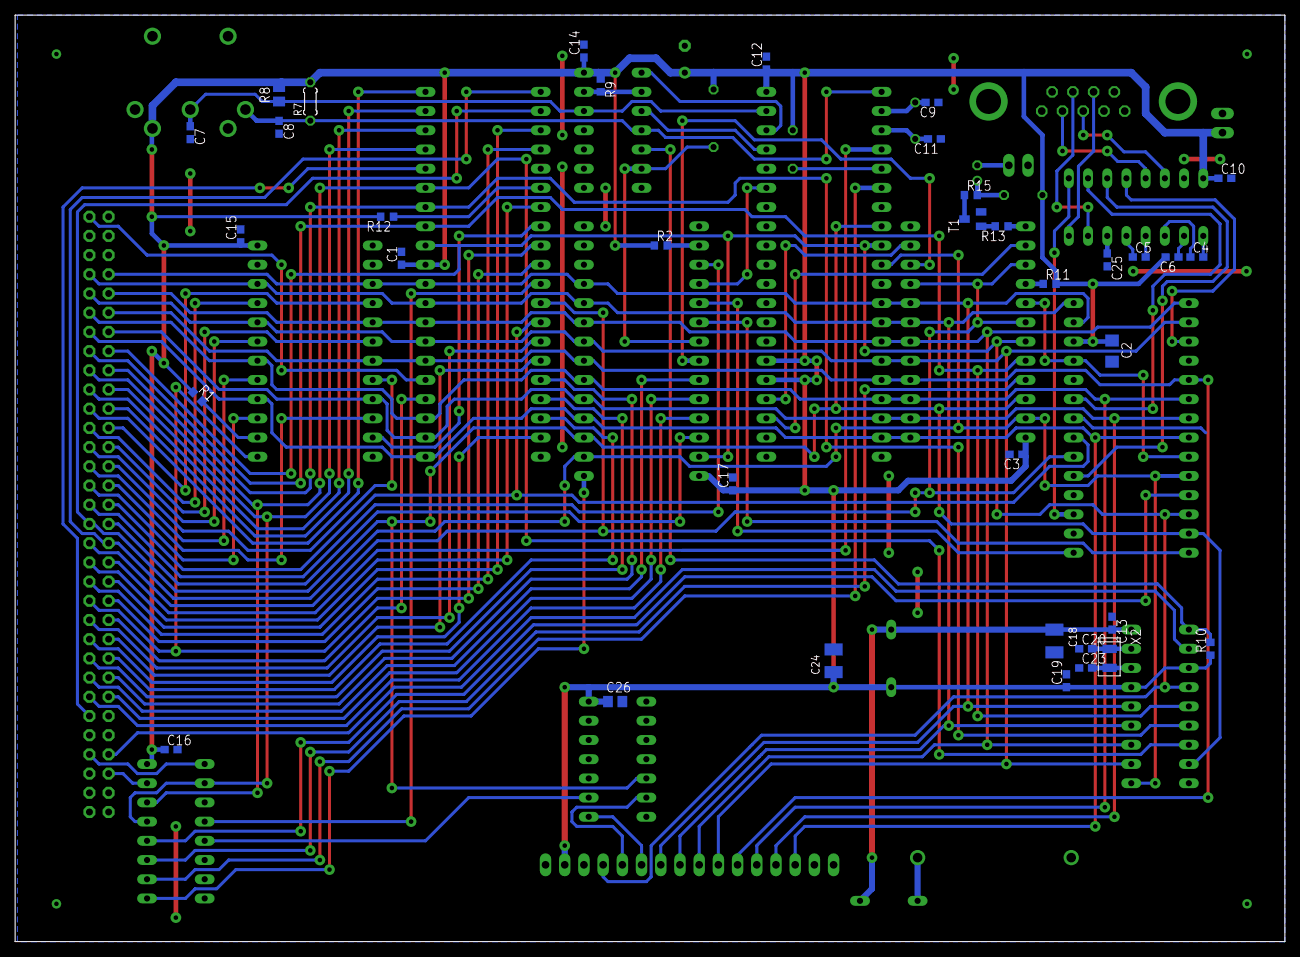
[picture p12: board 8085_IO_LCD.brd from below]

Board: 2 copper layers, 167.9 x 122.5 mm, 62 parts (36 on the bottom side), 106 nets.
