marekw1986/8085Computer/code/classic/CPM/boot.asm

BIOS_ADDR	EQU 0B200H
CCP_ADDR	EQU 9C00H

	org 0000H
LOAD_BASE:
	JMP BIOS_ADDR
IOBYTE:		DB 0
CDISK:		DB 0
	JMP CCP_ADDR
INTERRUPTS:	DS 48
RESTART7:	DS 3
RESERVED1:	DS 5
SCRATCH:	DS 16
RESERVED2:	DS 12
FILE_CONTROL_BLOCK:
			DS 33
RANDOM_RECORD_POSITION:
			DS 3
DISK_BUFFER:
			DS 128
