marekw1986/8085Computer/(commit log)

2024-06-05 PCB updated
    [8085.brd, 8085.sch]
2024-07-17 Reset circuit simplified
    [8085.brd, 8085.sch]
2024-07-17 Minor optimizations
    [8085.brd, 8085.sch]
2024-08-03 PCB design upadted
    [8085.brd, 8085.sch]
2024-08-05 Minor PCB updates
    [8085.brd, 8085.sch]
2024-08-05 Minor update
    [8085.brd]
2024-08-11 HW bug fixed, GAL added
    [8085.brd, 8085.sch]
2024-08-11 Minot HW fix
    [8085.brd]
2024-08-11 Yet another HW issue fixed:
    [8085.brd]
2024-09-02 IO board added
    [8085_IO.brd, 8085_IO.sch]
2024-09-18 LCD variant of IO board added
    [8085_IO_LCD.brd, 8085_IO_LCD.sch]
2024-12-26 Bug in PCB design fixed
    [8085.brd, 8085.sch]
2024-12-27 uart test updated
2024-12-30 Bug in PCB board design fixed
    [8085.brd, 8085.sch]
2025-01-03 Small edits in test uart
2025-01-03 CF indicator LED added to CPU board
    [8085.brd, 8085.sch]
2025-01-05 IO address decoder gated with IOM signal
    [8085.brd, 8085.sch]
2025-01-05 minor PCB change
    [8085.brd]
2025-01-05 Another minor PCB update
    [8085.brd, 8085.sch]
2025-01-17 Bugs in PCB board fixed
    [8085.brd, 8085.sch]
2025-01-19 CPU board updated
    [8085.brd, 8085.sch]
2025-01-23 Small changes in PCB design
    [8085.brd, 8085.sch]
2025-01-24 CPU board design updated. 7474 chip added to synchronize address decoders activity with ALE line.
    [8085.brd, 8085.sch]
2025-02-05 Shadowed rom option added
    [8085_shadow.brd, 8085_shadow.sch]
2025-03-13 CF write optimization while first sector of new track is being written
2025-03-13 ROM shadowed version: dependancies from bootloader removed from BIOS. Some libraries removed to separate files to preserve space. Minor refactoring. Experiments with writing (not working for now).
    [bios.asm, utils.asm]
2025-03-14 Fix in CP/M CF driver for shadowed ROM version
2025-03-15 Bug in CF card driver fixed
2025-04-10 Shadower added
    [shadower.brd, shadower.sch]
2025-09-11 MVI A, 00H replaced with XOR A to preserve memory and CPU cycles
    [bios.asm, blink.asm, bootloader.asm, keyboard.asm, test_uart.asm]
2025-09-11 CPI 00H replaced with OR A
    [bios.asm, bootloader.asm, keyboard.asm, utils.asm]
2025-09-11 Revert "MVI A, 00H replaced with XOR A to preserve memory and CPU cycles"
    This reverts commit 7e88d7f649f19ed6bf6bc259cda6de55ba1163e5.
    [bios.asm, blink.asm, bootloader.asm, keyboard.asm, test_uart.asm]
2025-09-11 Revert "CPI 00H replaced with OR A"
    This reverts commit c14340f54a100b10e82b98b0e9cdf4dc6df40ed7.
    [bios.asm, bootloader.asm, keyboard.asm, utils.asm]
2025-09-11 MVI A, 00H replaced with XRA A
    [bios.asm, blink.asm, bootloader.asm, keyboard.asm, test_uart.asm]
2025-09-11 CPI 00H replaced with ORA A
    [bios.asm, bootloader.asm, keyboard.asm, utils.asm]
2025-09-14 Bug in READ procedure fixed
    [bios.asm]
2025-09-14 MVI A, 0 replaced wit XRA A in bios.asm
    [bios.asm]
2025-09-17 Moving to ASL assembler and 8085undoc. In next step bootloader and CP/M bios will be optimized with undocummented 8085 instructions
